GadgetReboot/Audio_Share/README.md

# Audio_Share
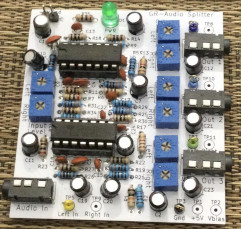
[picture p1: Assembled_PCB.jpg]
PCB
<br><br><BR><BR>
Take one stereo audio line input and share to 3 line outputs with level adjust
