GadgetReboot/Audio_Share/BOM - GR_Audio_Share.pdf

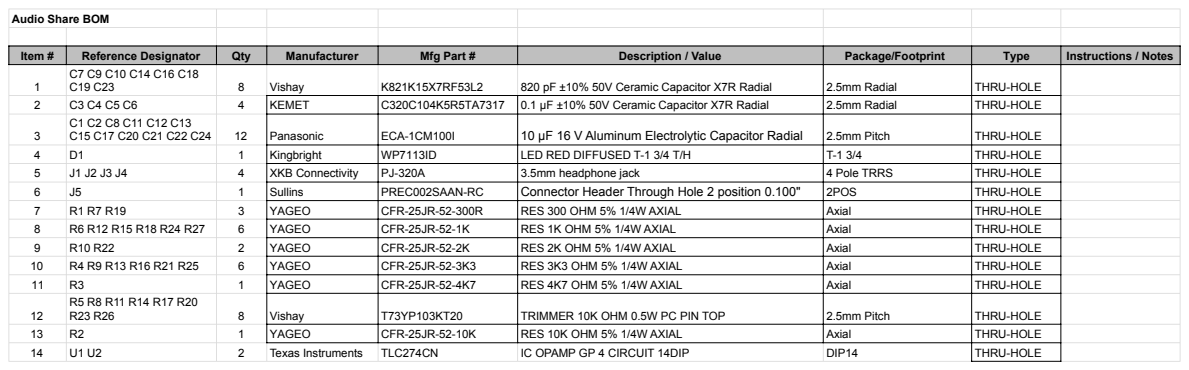
[picture p2: page 1]
