GadgetReboot/Audio_Share/GR_Audio_Share_Sch.pdf

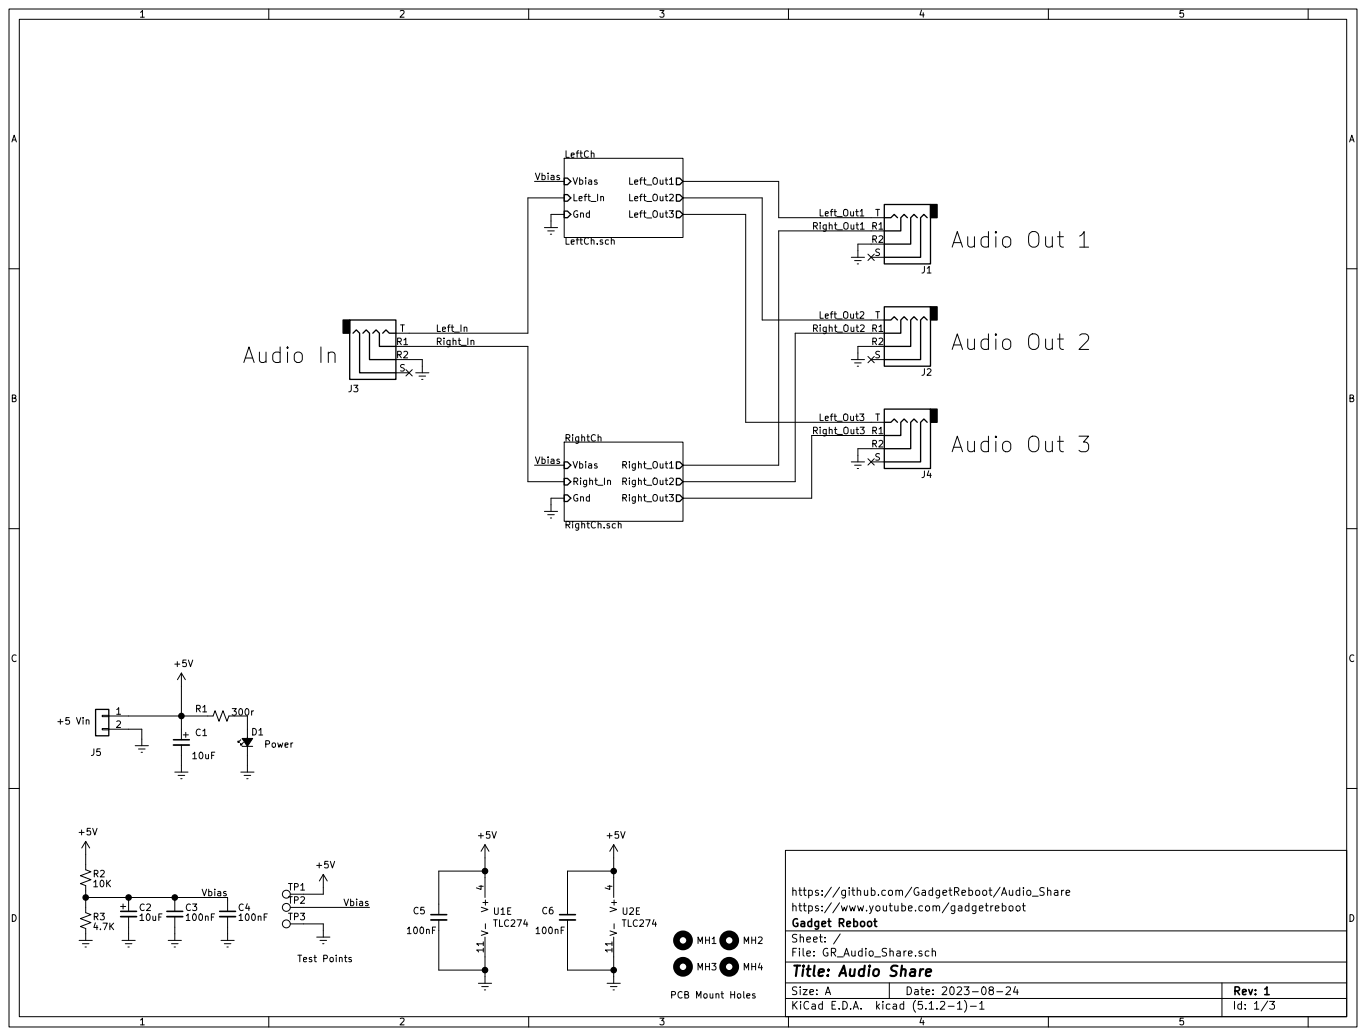
[picture p3: page 1]

https://github.com/GadgetReboot/Audio_Share C1

https://www.youtube.com/gadgetreboot
File: GR_Audio_Share.sch Sheet: / Gadget Reboot

Id: 1/3 Title: Audio Share

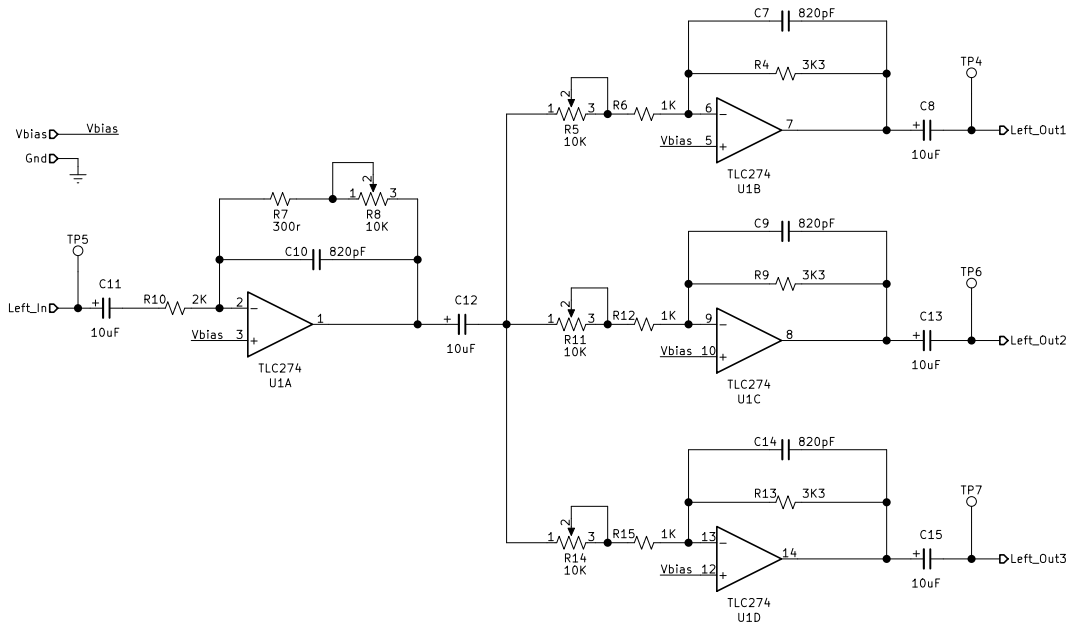
[picture p4: page 2]

https://github.com/GadgetReboot/Audio_Share
https://www.youtube.com/gadgetreboot
File: LeftCh.sch Sheet: /LeftCh/ Gadget Reboot

Id: 2/3 Title: Audio Share

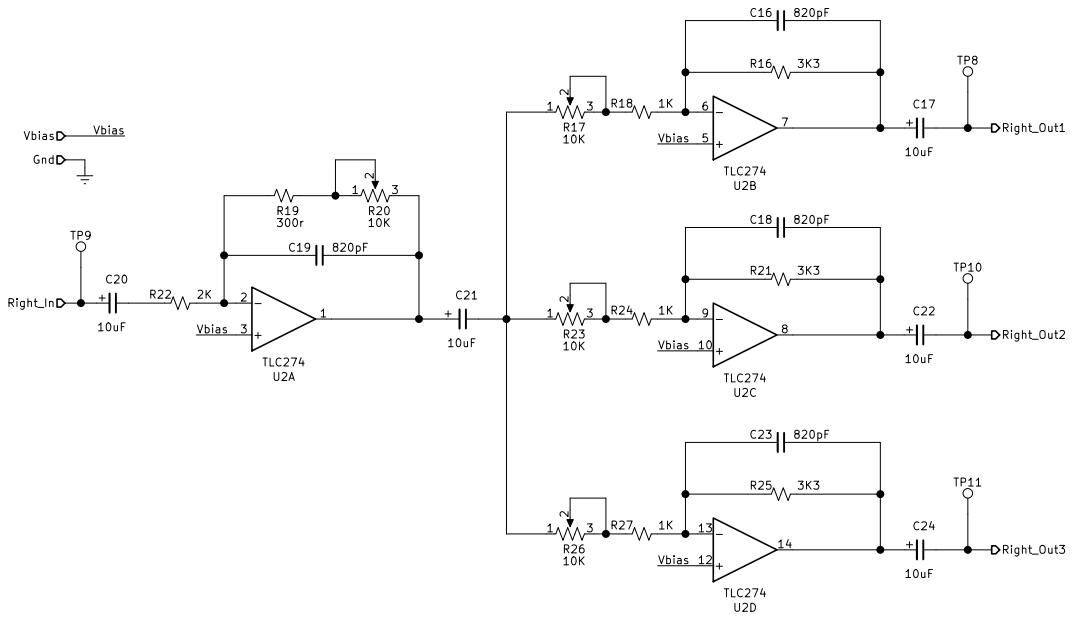
[picture p5: page 3]

https://github.com/GadgetReboot/Audio_Share
https://www.youtube.com/gadgetreboot
Gadget Reboot
Sheet: /RightCh/
File: RightCh.sch
Id: 3/3 Title: Audio Share
