GadgetReboot/Audio_Share/KiCad/GR_Audio_Share.kicad_pcb

## KiCad design KiCad/GR_Audio_Share.kicad_pcb (2023-08-24)

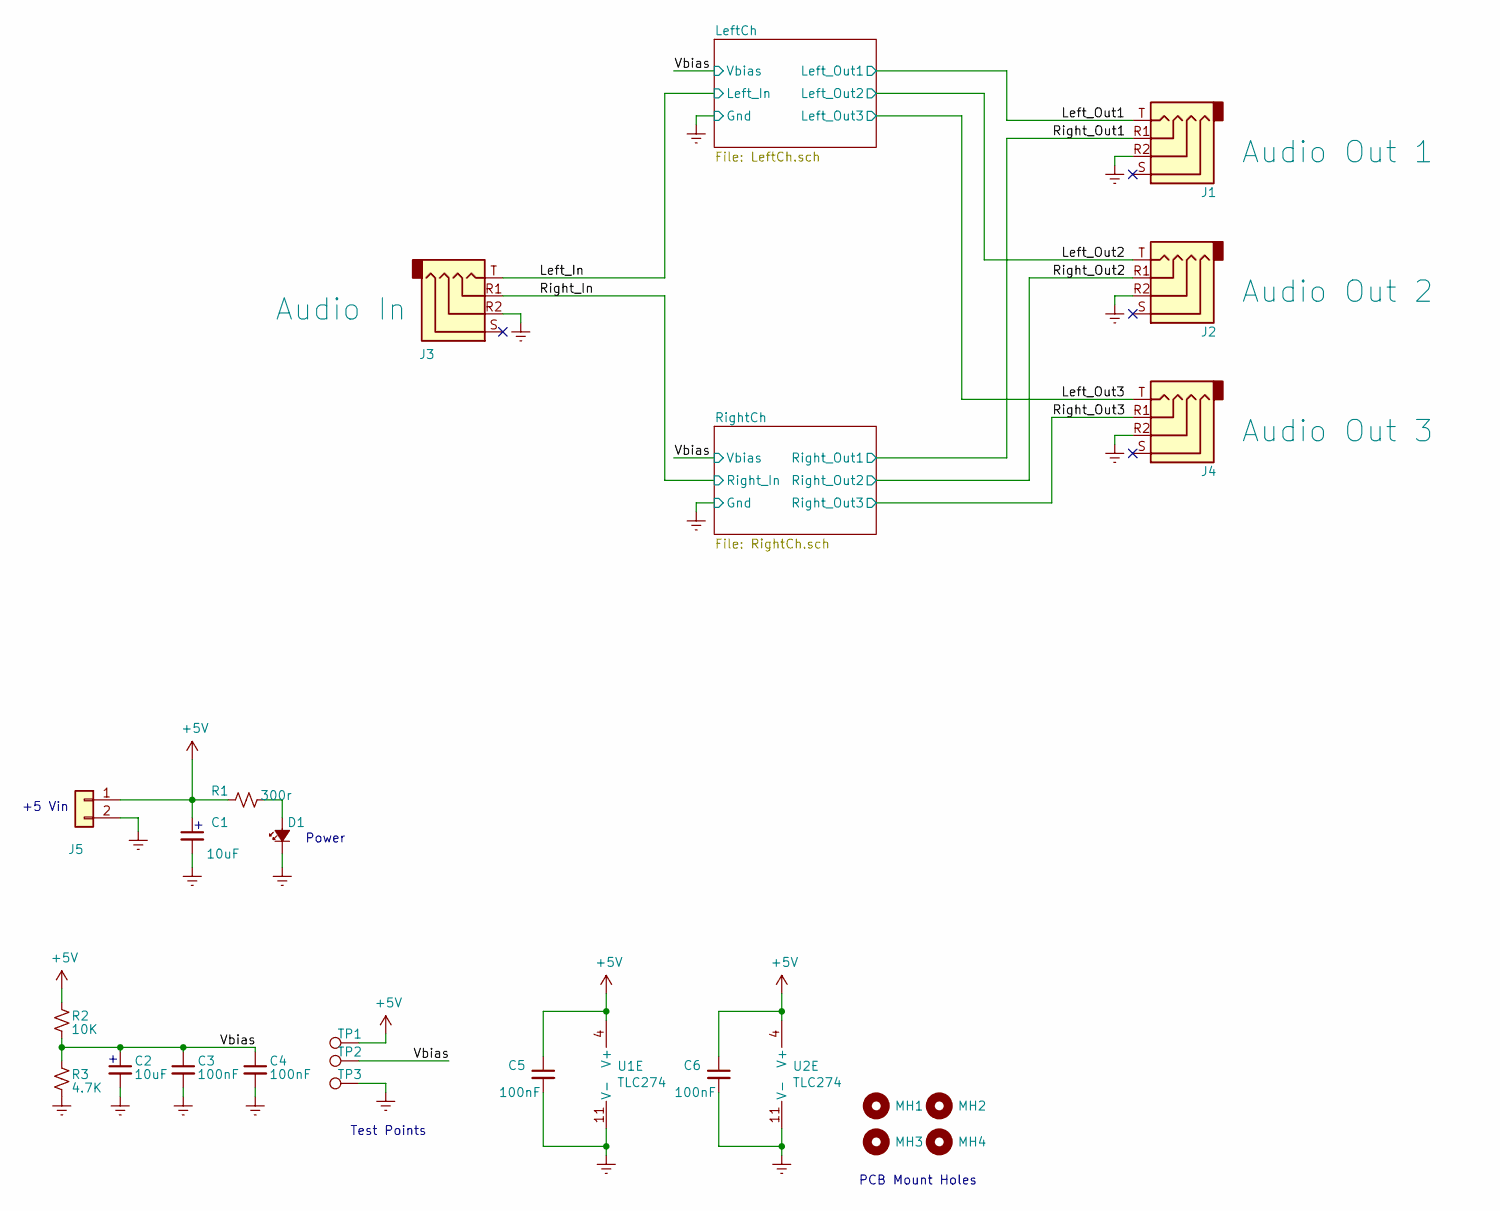
[picture p6: schematic GR_Audio_Share.sch, Audio Share]

Parts:
C1, C2: 10uF; CP_Radial_D5.0mm_P2.50mm
C3, C4, C5, C6: 100nF; C_Disc_D3.0mm_W2.0mm_P2.50mm
D1: LED_Small_ALT; LED_D5.0mm
J1: Audio Out 1; PJ320A
J2: Audio Out 2; PJ320A
J3: Audio In; PJ320A
J4: Audio Out 3; PJ320A
J5: Conn_01x02; PinHeader_1x02_P2.54mm_Vertical
MH1, MH2, MH3, MH4: MountingHole; MountingHole_3.2mm_M3
R1: 300r; R_Axial_DIN0204_L3.6mm_D1.6mm_P7.62mm_Horizontal
R2: 10K; R_Axial_DIN0204_L3.6mm_D1.6mm_P7.62mm_Horizontal
R3: 4.7K; R_Axial_DIN0204_L3.6mm_D1.6mm_P7.62mm_Horizontal
TP1, TP2, TP3: TestPoint; TestPoint_Loop_D1.80mm_Drill1.0mm_Beaded
U1, U2: TLC274; DIP-14_W7.62mm_Socket_LongPads

Connections:
+5V: C1.1, C5.1, C6.1, J5.1, R1.1, R2.2, TP1.1, U1.4 (V+), U2.4 (V+)
/Left_In: J3.T; also elsewhere on the board
/Left_Out1: J1.T; also elsewhere on the board
/Left_Out2: J2.T; also elsewhere on the board
/Left_Out3: J4.T; also elsewhere on the board
/Right_In: J3.R1; also elsewhere on the board
/Right_Out1: J1.R1; also elsewhere on the board
/Right_Out2: J2.R1; also elsewhere on the board
/Right_Out3: J4.R1; also elsewhere on the board
/Vbias: C2.1, C3.1, C4.1, R2.1, R3.2, TP2.1; also elsewhere on the board
GNDREF: C1.2, C2.2, C3.2, C4.2, C5.2, C6.2, D1.1 (K), J1.R2, J2.R2, J3.R2, J4.R2, J5.2, R3.1, TP3.1, U1.11 (V-), U2.11 (V-)
unnamed: D1.2 (A), R1.2

Notes on the sheet:
+5 Vin
PCB Mount Holes
Test Points
Power

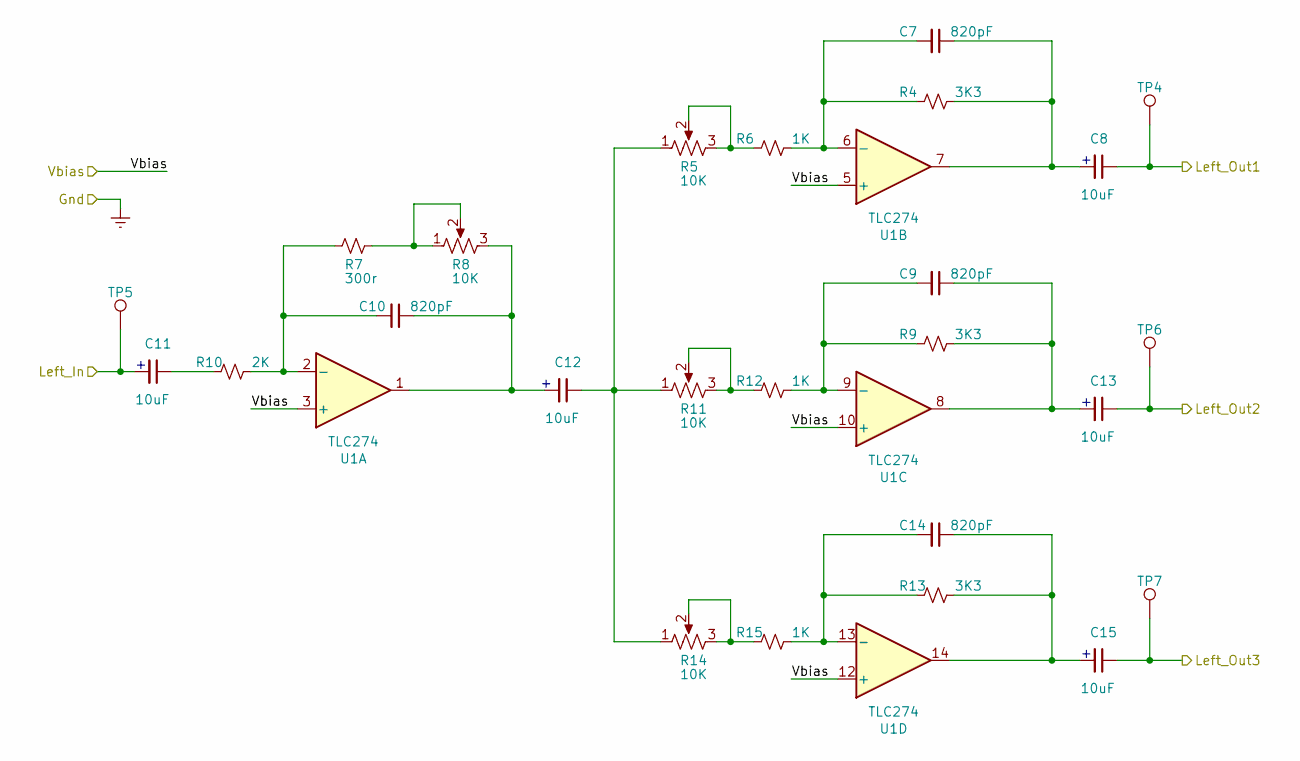
[picture p7: schematic LeftCh.sch, Audio Splitter]

Parts:
C7, C9, C10, C14: 820pF; C_Disc_D3.0mm_W2.0mm_P2.50mm
C8, C11, C12, C13, C15: 10uF; CP_Radial_D5.0mm_P2.50mm
R4, R9, R13: 3K3; R_Axial_DIN0204_L3.6mm_D1.6mm_P7.62mm_Horizontal
R5, R8, R11, R14: 10K; Potentiometer_Vishay_T73YP_Vertical
R6, R12, R15: 1K; R_Axial_DIN0204_L3.6mm_D1.6mm_P7.62mm_Horizontal
R7: 300r; R_Axial_DIN0204_L3.6mm_D1.6mm_P7.62mm_Horizontal
R10: 2K; R_Axial_DIN0204_L3.6mm_D1.6mm_P7.62mm_Horizontal
TP4, TP5, TP6, TP7: TestPoint; TestPoint_Loop_D1.80mm_Drill1.0mm_Beaded
U1: TLC274; DIP-14_W7.62mm_Socket_LongPads

Connections:
/Left_In: C11.2, TP5.1; also elsewhere on the board
/Left_Out1: C8.1, TP4.1; also elsewhere on the board
/Left_Out2: C13.1, TP6.1; also elsewhere on the board
/Left_Out3: C15.1, TP7.1; also elsewhere on the board
/Vbias: U1.3 (+), U1.5 (+), U1.10 (+), U1.12 (+); also elsewhere on the board
unnamed: C7.1, C8.2, R4.2, U1.7
unnamed: C7.2, R4.1, R6.2, U1.6 (-)
unnamed: C9.2, R9.1, R12.2, U1.9 (-)
unnamed: C10.1, C12.2, R8.3, U1.1
unnamed: C10.2, R7.1, R10.2, U1.2 (-)
unnamed: C11.1, R10.1
unnamed: C12.1, R5.1, R11.1, R14.1
unnamed: C9.1, C13.2, R9.2, U1.8
unnamed: C14.1, C15.2, R13.2, U1.14
unnamed: C14.2, R13.1, R15.2, U1.13 (-)
unnamed: R5.2, R5.3, R6.1
unnamed: R7.2, R8.1, R8.2
unnamed: R11.2, R11.3, R12.1
unnamed: R14.2, R14.3, R15.1

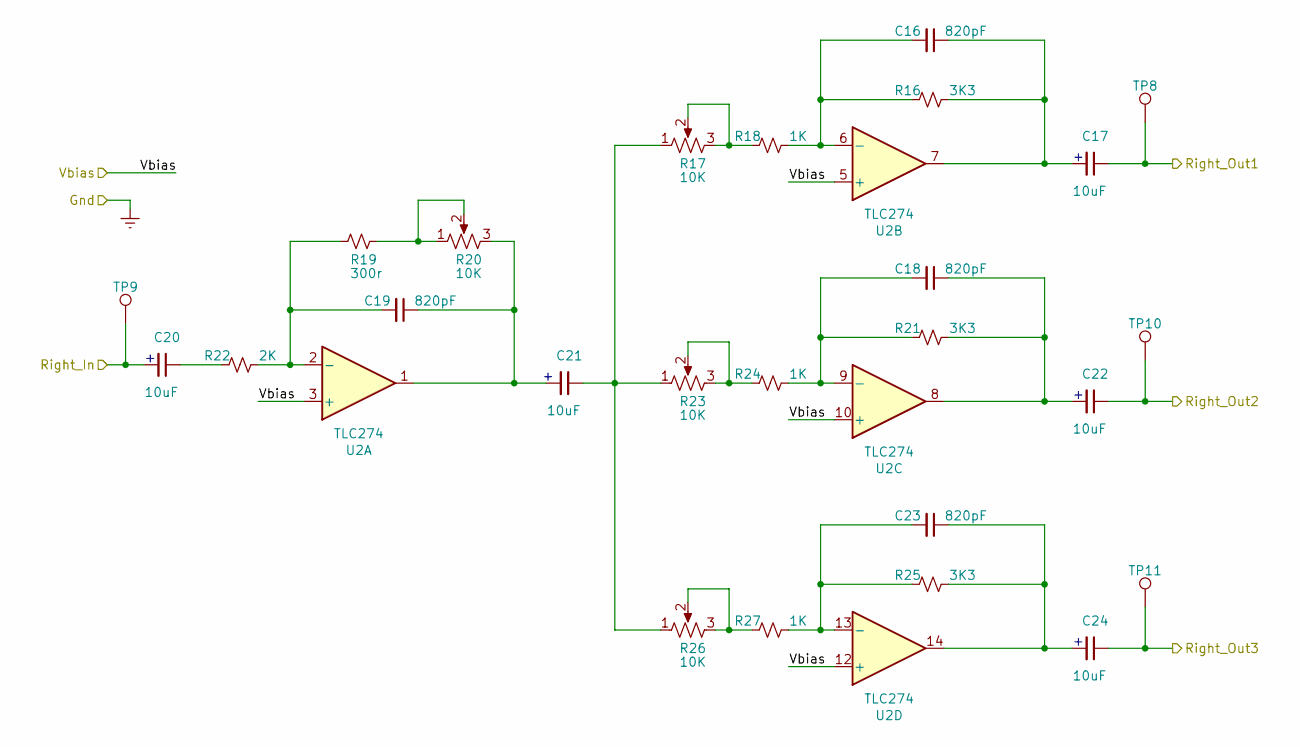
[picture p8: schematic RightCh.sch, Audio Splitter]

Parts:
C16, C18, C19, C23: 820pF; C_Disc_D3.0mm_W2.0mm_P2.50mm
C17, C20, C21, C22, C24: 10uF; CP_Radial_D5.0mm_P2.50mm
R16, R21, R25: 3K3; R_Axial_DIN0204_L3.6mm_D1.6mm_P7.62mm_Horizontal
R17, R20, R23, R26: 10K; Potentiometer_Vishay_T73YP_Vertical
R18, R24, R27: 1K; R_Axial_DIN0204_L3.6mm_D1.6mm_P7.62mm_Horizontal
R19: 300r; R_Axial_DIN0204_L3.6mm_D1.6mm_P7.62mm_Horizontal
R22: 2K; R_Axial_DIN0204_L3.6mm_D1.6mm_P7.62mm_Horizontal
TP8, TP9, TP10, TP11: TestPoint; TestPoint_Loop_D1.80mm_Drill1.0mm_Beaded
U2: TLC274; DIP-14_W7.62mm_Socket_LongPads

Connections:
/Right_In: C20.2, TP9.1; also elsewhere on the board
/Right_Out1: C17.1, TP8.1; also elsewhere on the board
/Right_Out2: C22.1, TP10.1; also elsewhere on the board
/Right_Out3: C24.1, TP11.1; also elsewhere on the board
/Vbias: U2.3 (+), U2.5 (+), U2.10 (+), U2.12 (+); also elsewhere on the board
unnamed: C16.1, C17.2, R16.2, U2.7
unnamed: C16.2, R16.1, R18.2, U2.6 (-)
unnamed: C18.1, C22.2, R21.2, U2.8
unnamed: C18.2, R21.1, R24.2, U2.9 (-)
unnamed: C19.1, C21.2, R20.3, U2.1
unnamed: C19.2, R19.1, R22.2, U2.2 (-)
unnamed: C20.1, R22.1
unnamed: C21.1, R17.1, R23.1, R26.1
unnamed: C23.1, C24.2, R25.2, U2.14
unnamed: C23.2, R25.1, R27.2, U2.13 (-)
unnamed: R17.2, R17.3, R18.1
unnamed: R19.2, R20.1, R20.2
unnamed: R23.2, R23.3, R24.1
unnamed: R26.2, R26.3, R27.1

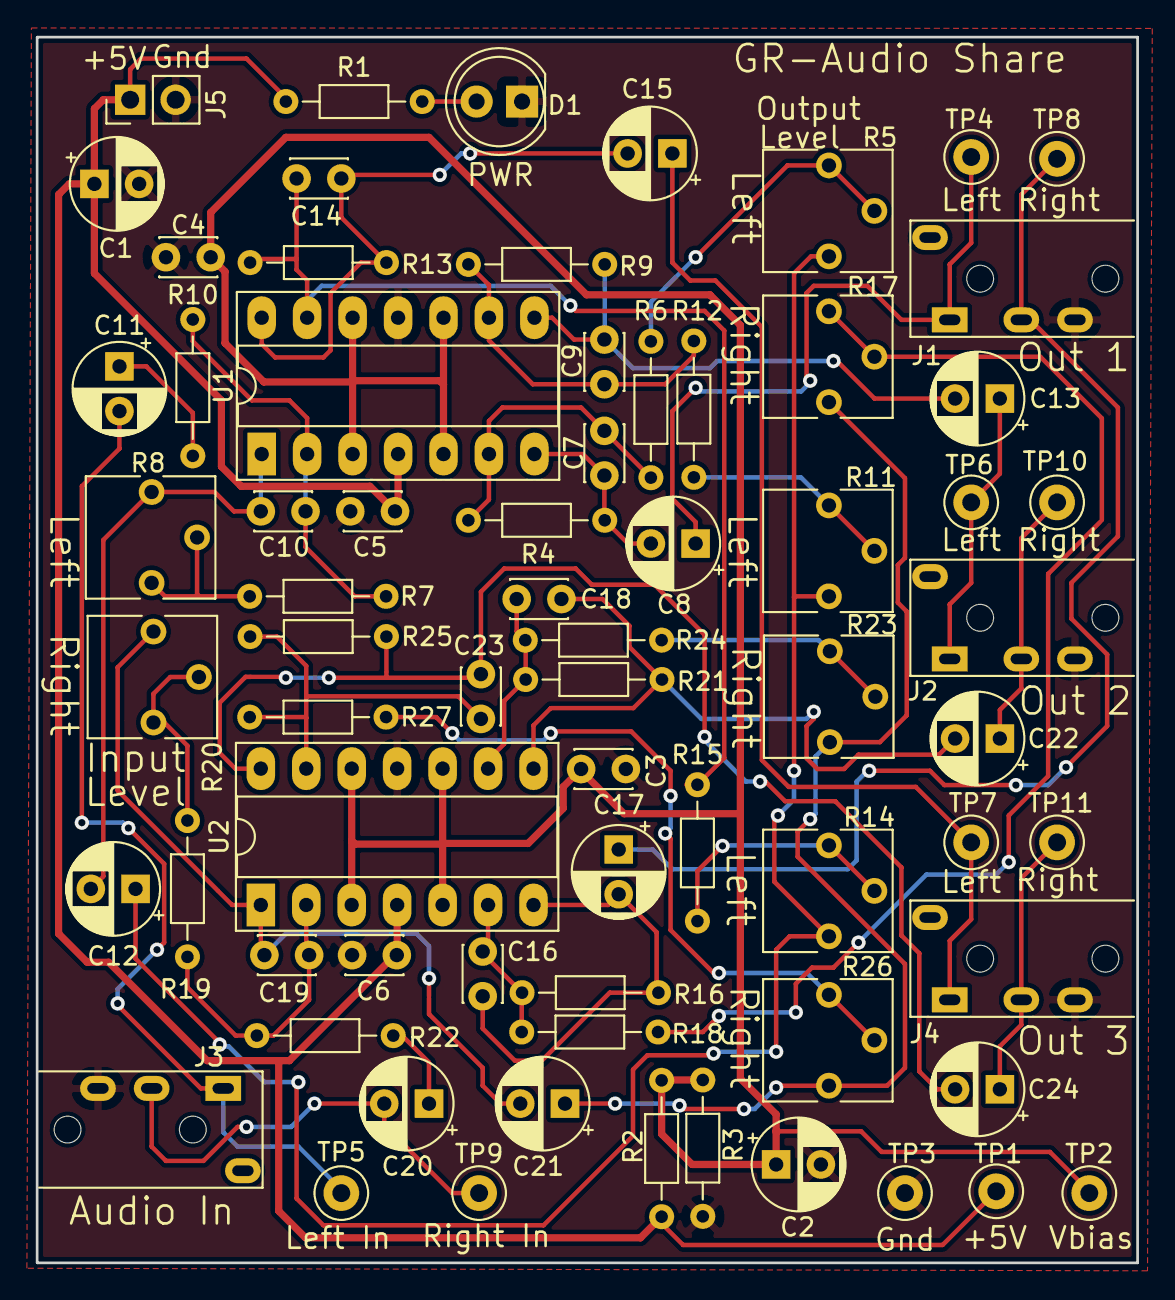
[picture p9: board GR_Audio_Share.kicad_pcb from above]

Board: 2 copper layers, 61.5 x 68.5 mm, 70 parts (0 on the bottom side), 40 nets.
